lucianpapadopol/ArduinoDUE-VNA/Pic's/test_dds_b.jpg

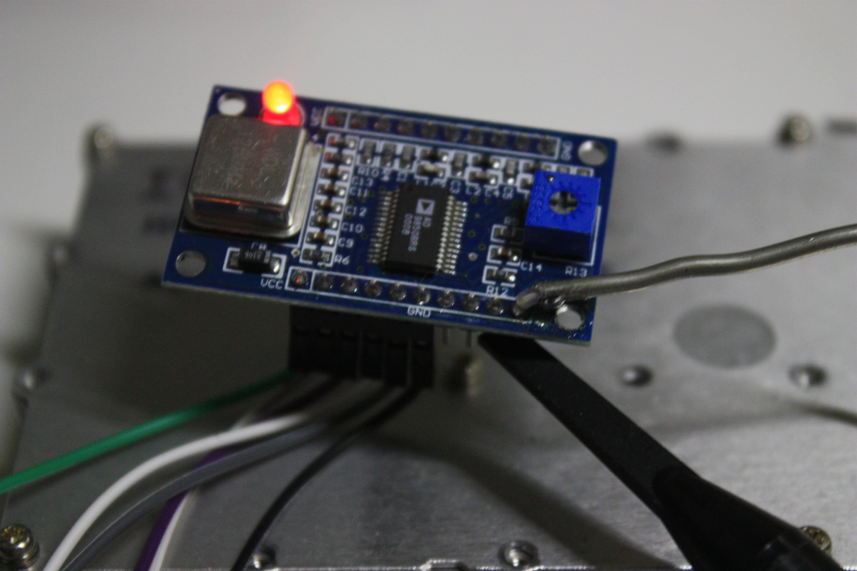
Pic's/test_dds_b.jpg
