lucianpapadopol/ArduinoDUE-VNA/Pic's/test_dds_uscita_b.jpg

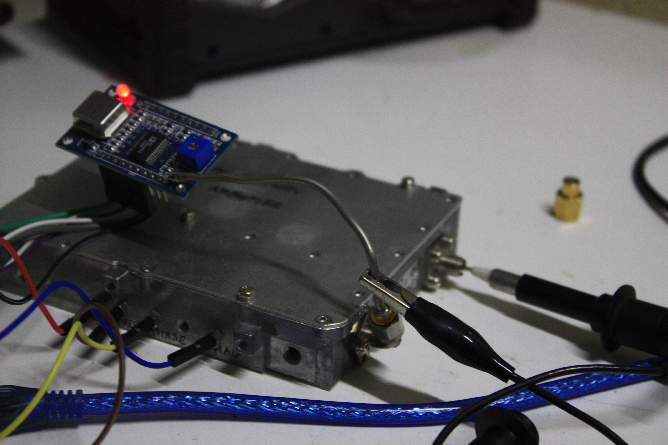
Pic's/test_dds_uscita_b.jpg
