lucianpapadopol/ArduinoDUE-VNA/DOC & INFO/schema a blocchi.jpg

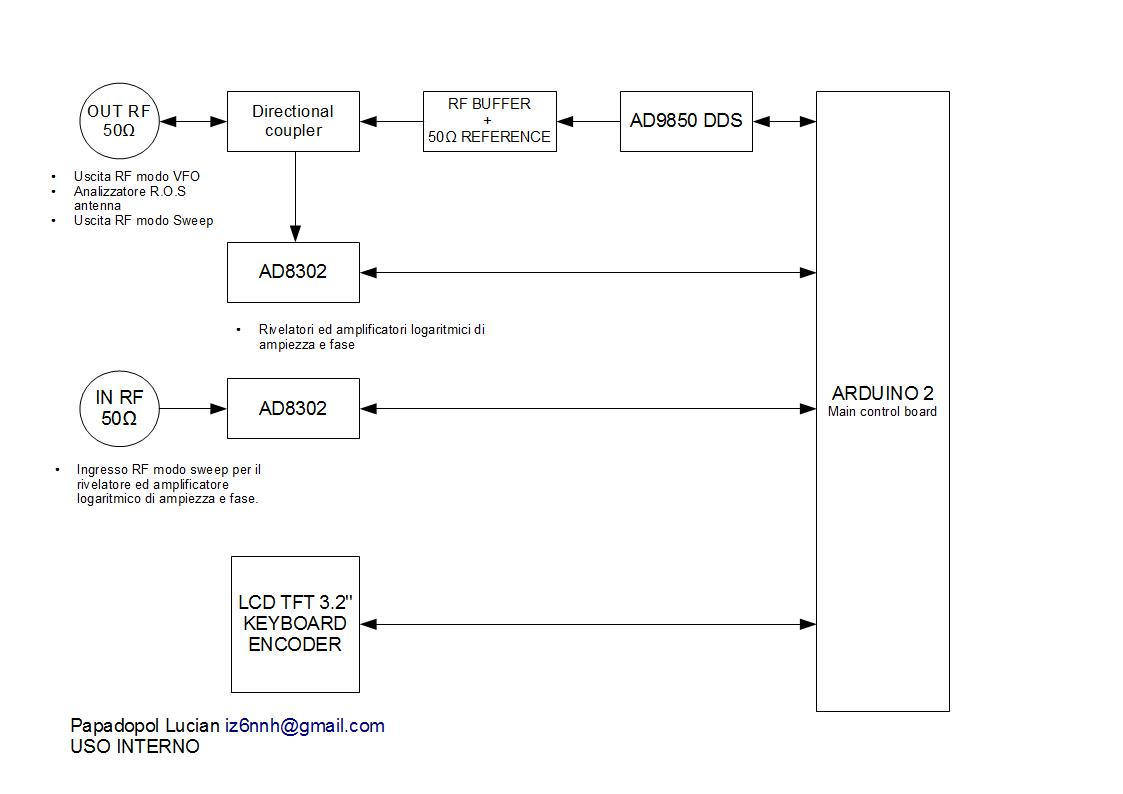
DOC & INFO/schema a blocchi.jpg
