lucianpapadopol/ArduinoDUE-VNA/Pic's/accoppiatore_pcb_a.jpg

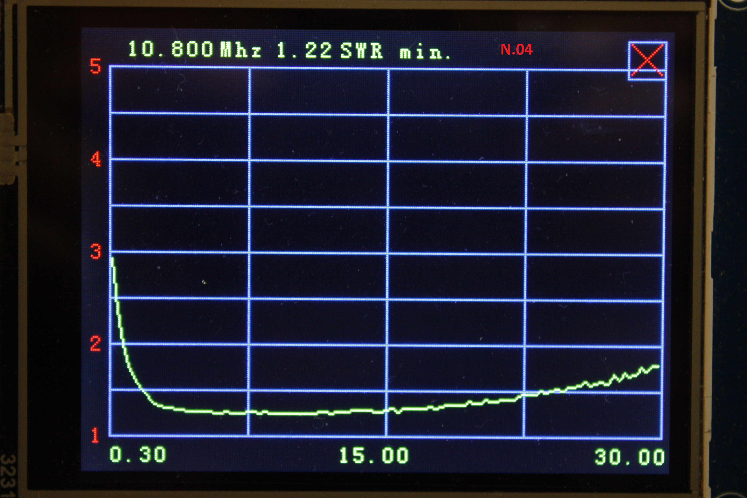
Pic's/accoppiatore_pcb_a.jpg
