lucianpapadopol/ArduinoDUE-VNA/Pic's/accoppiatore_pcb_b.jpg

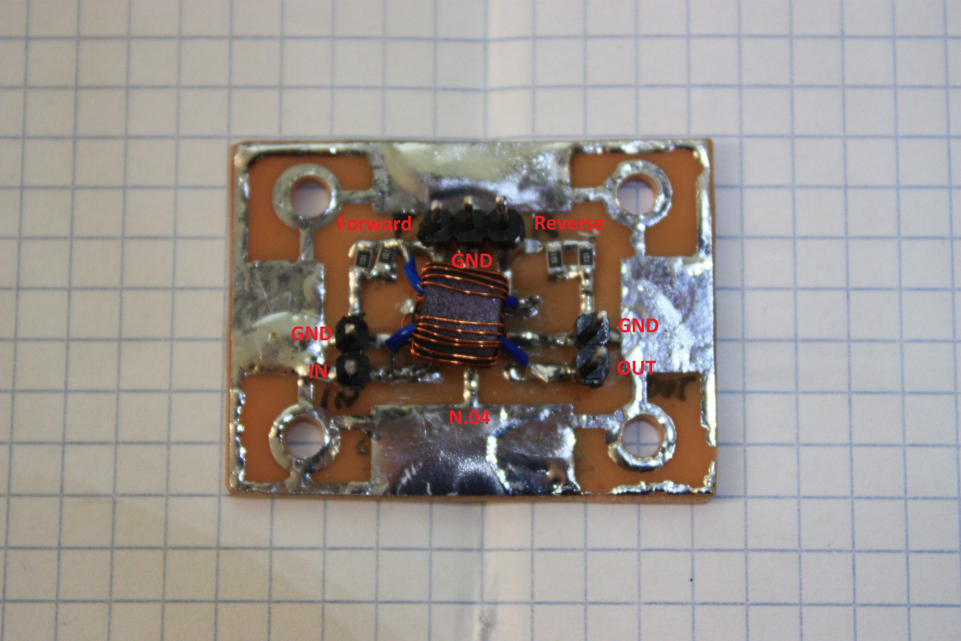
Pic's/accoppiatore_pcb_b.jpg
