lucianpapadopol/ArduinoDUE-VNA/Pic's/ad8302.jpg

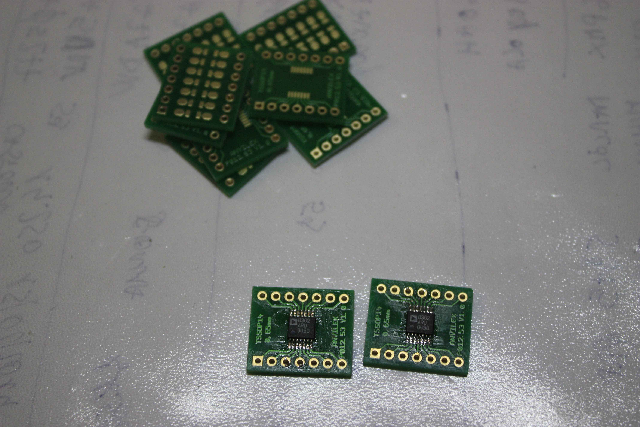
Pic's/ad8302.jpg
