lucianpapadopol/ArduinoDUE-VNA/Pic's/ad8302_b.jpg

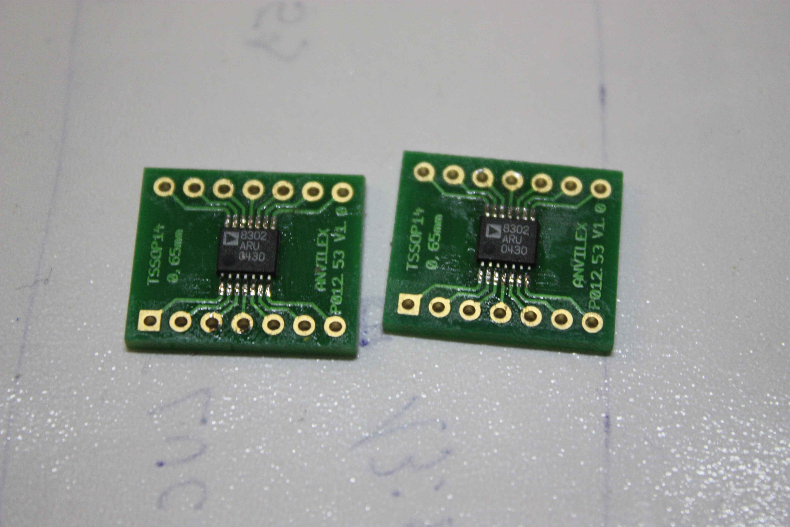
Pic's/ad8302_b.jpg
