lucianpapadopol/ArduinoDUE-VNA/Pic's/dds_conn.jpg

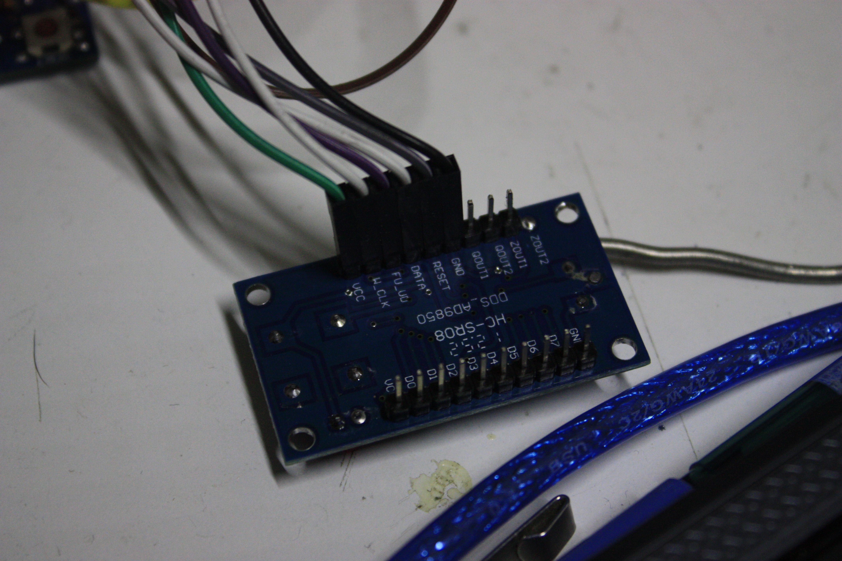
Pic's/dds_conn.jpg
