lucianpapadopol/ArduinoDUE-VNA/Pic's/fase.png

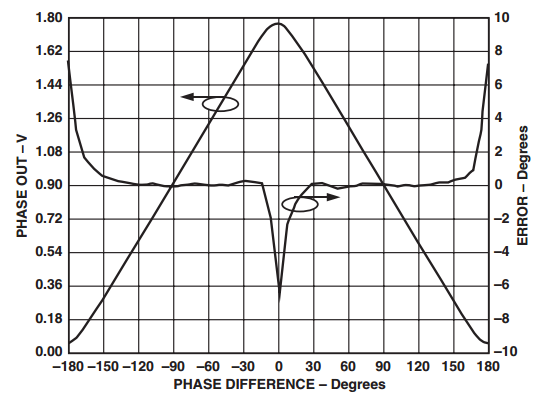
Pic's/fase.png
