lucianpapadopol/ArduinoDUE-VNA/Pic's/grafico swr.jpg

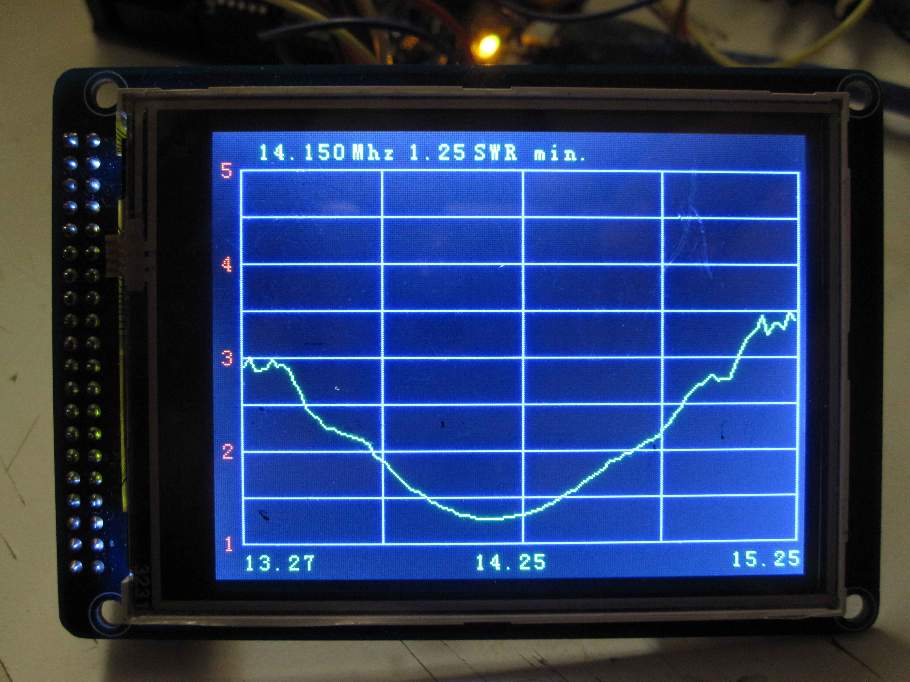
Pic's/grafico swr.jpg
