lucianpapadopol/ArduinoDUE-VNA/Pic's/logamp2.jpg

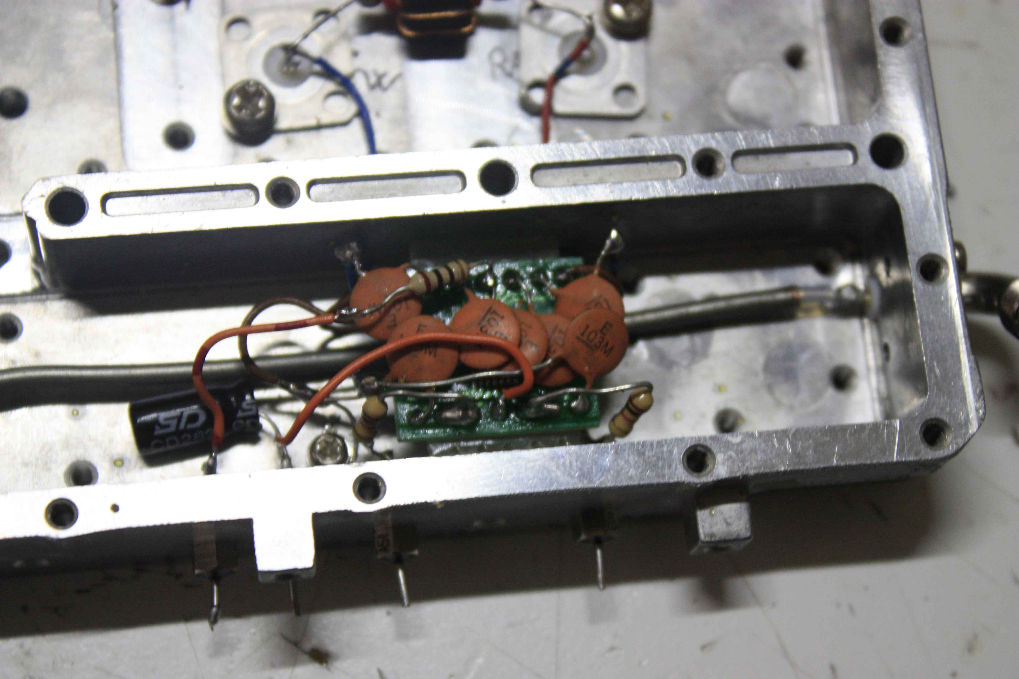
Pic's/logamp2.jpg
