lucianpapadopol/ArduinoDUE-VNA/Pic's/logamp3.jpg

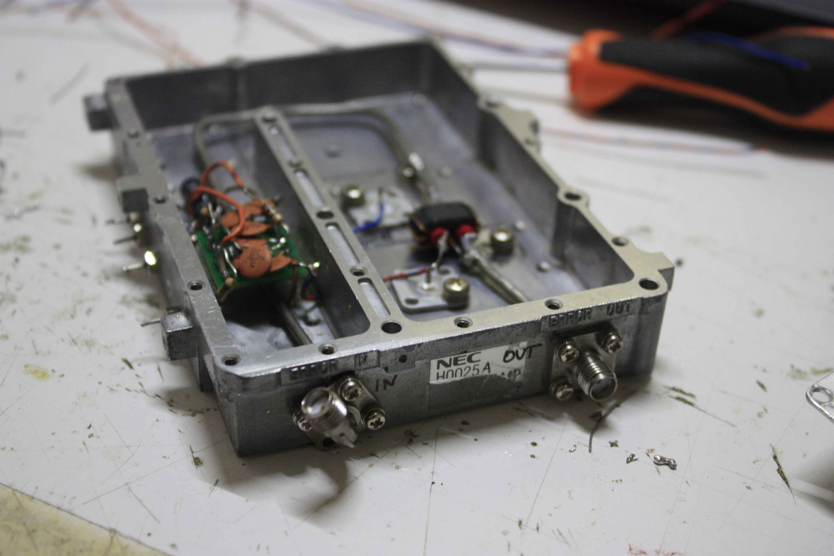
Pic's/logamp3.jpg
