lucianpapadopol/ArduinoDUE-VNA/Pic's/logamp4.jpg

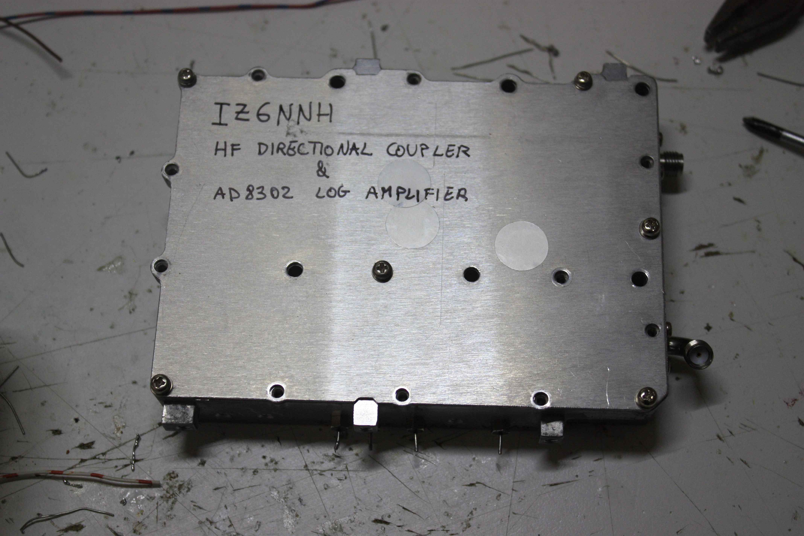
Pic's/logamp4.jpg
