lucianpapadopol/ArduinoDUE-VNA/Pic's/logamp.jpg

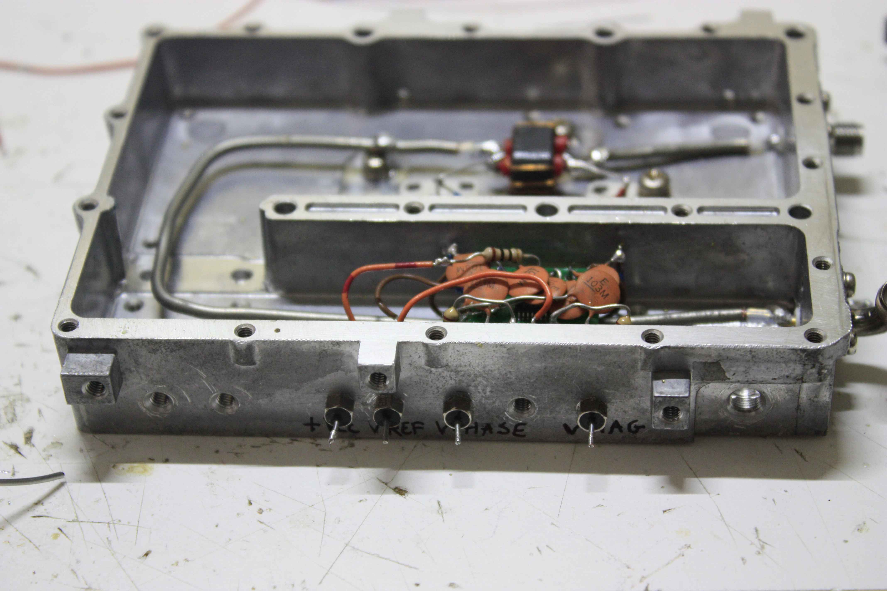
Pic's/logamp.jpg
