lucianpapadopol/ArduinoDUE-VNA/Pic's/mod_rf.jpg

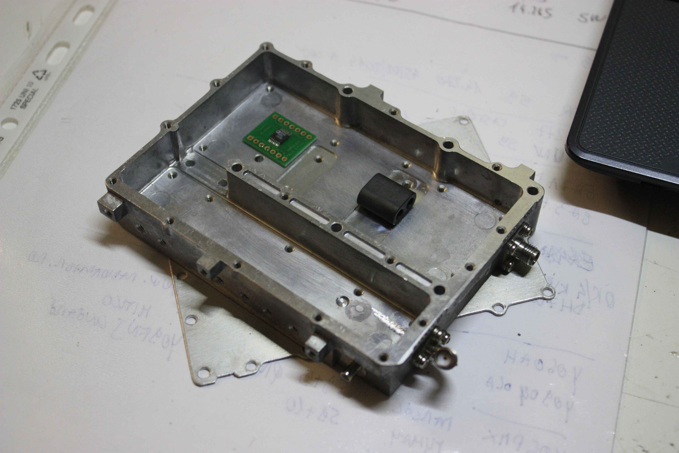
Pic's/mod_rf.jpg
