lucianpapadopol/ArduinoDUE-VNA/Pic's/modalità_vfo.jpg

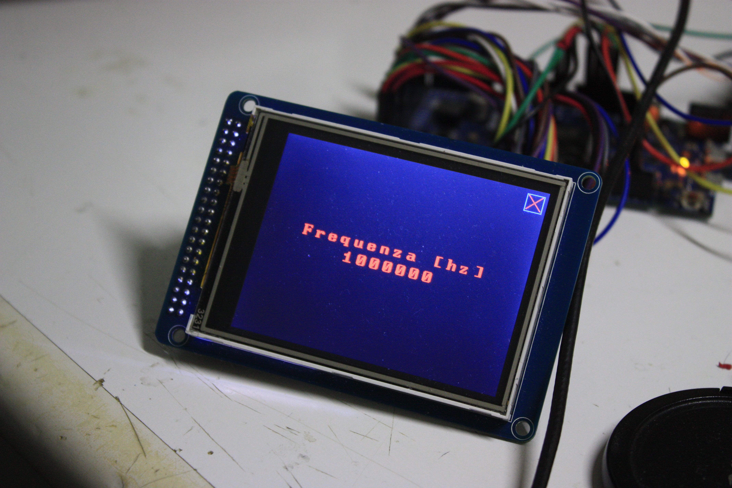
Pic's/modalità_vfo.jpg
