lucianpapadopol/ArduinoDUE-VNA/Pic's/tandem_match_coupler1.jpg

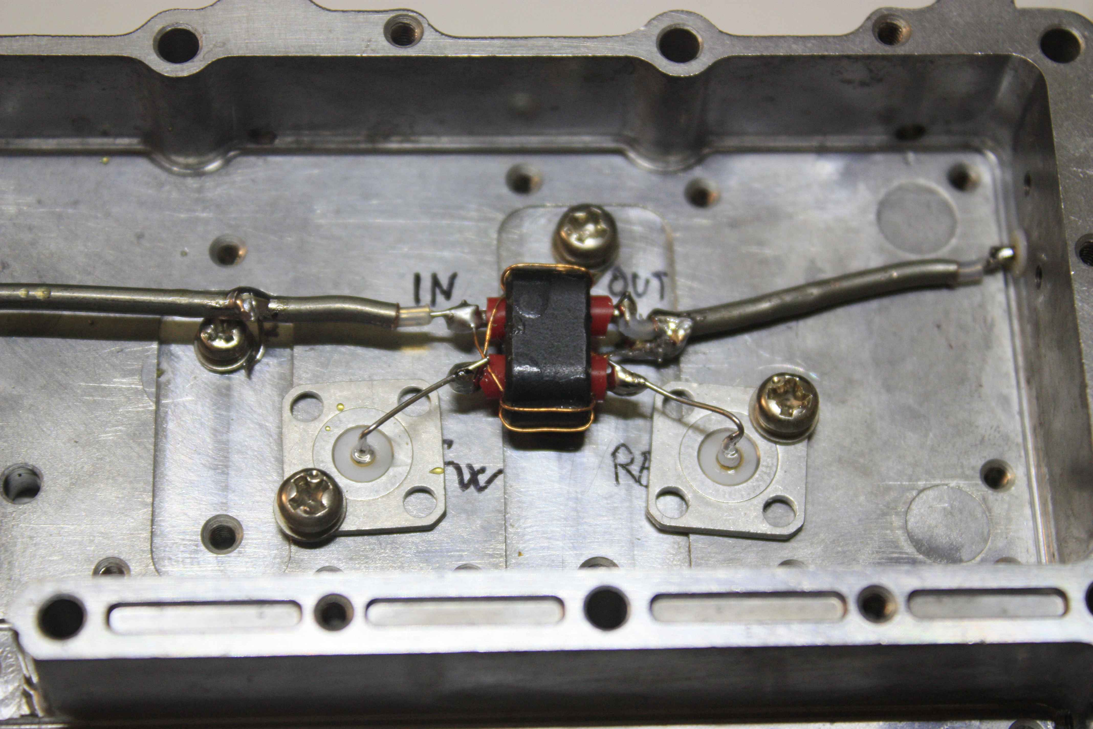
Pic's/tandem_match_coupler1.jpg
