lucianpapadopol/ArduinoDUE-VNA/Pic's/tandem_match_coupler2.jpg

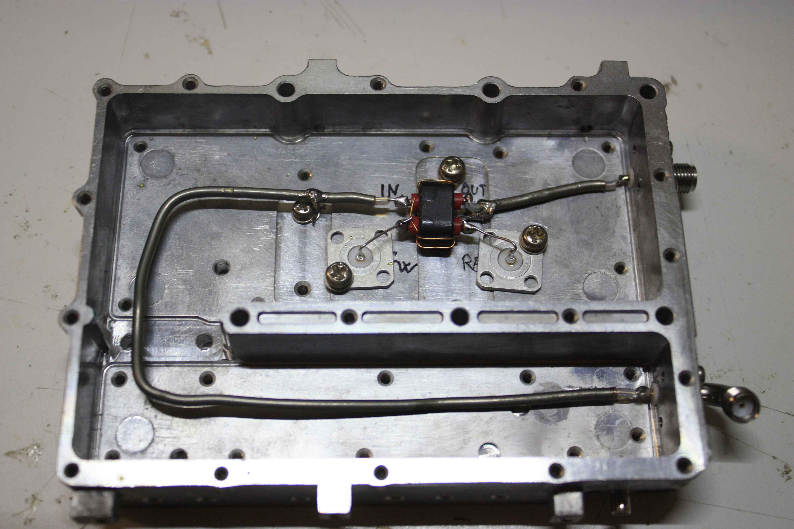
Pic's/tandem_match_coupler2.jpg
