lucianpapadopol/ArduinoDUE-VNA/Pic's/uscita_1mhz_dds.jpg

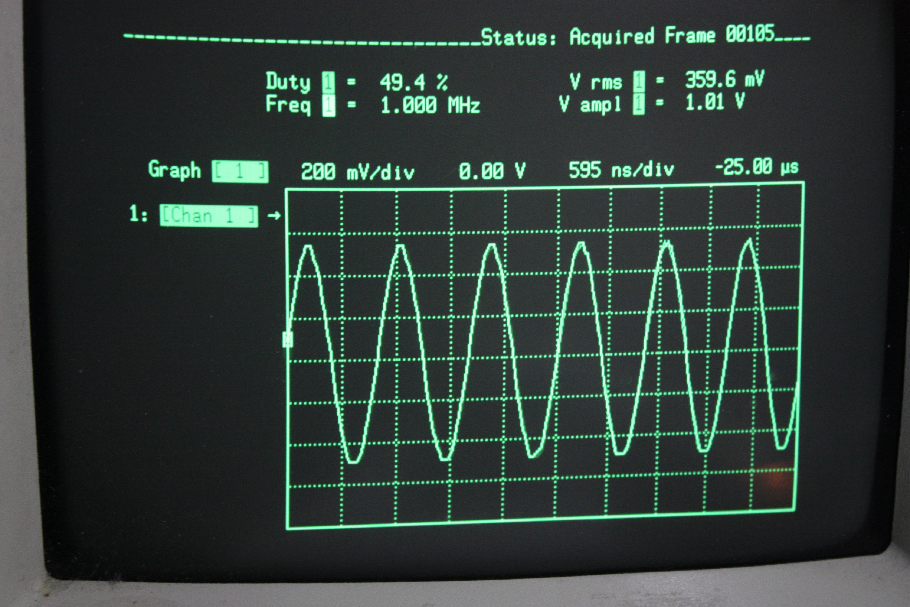
Pic's/uscita_1mhz_dds.jpg
