lucianpapadopol/ArduinoDUE-VNA/Pic's/vista d'insieme.jpg

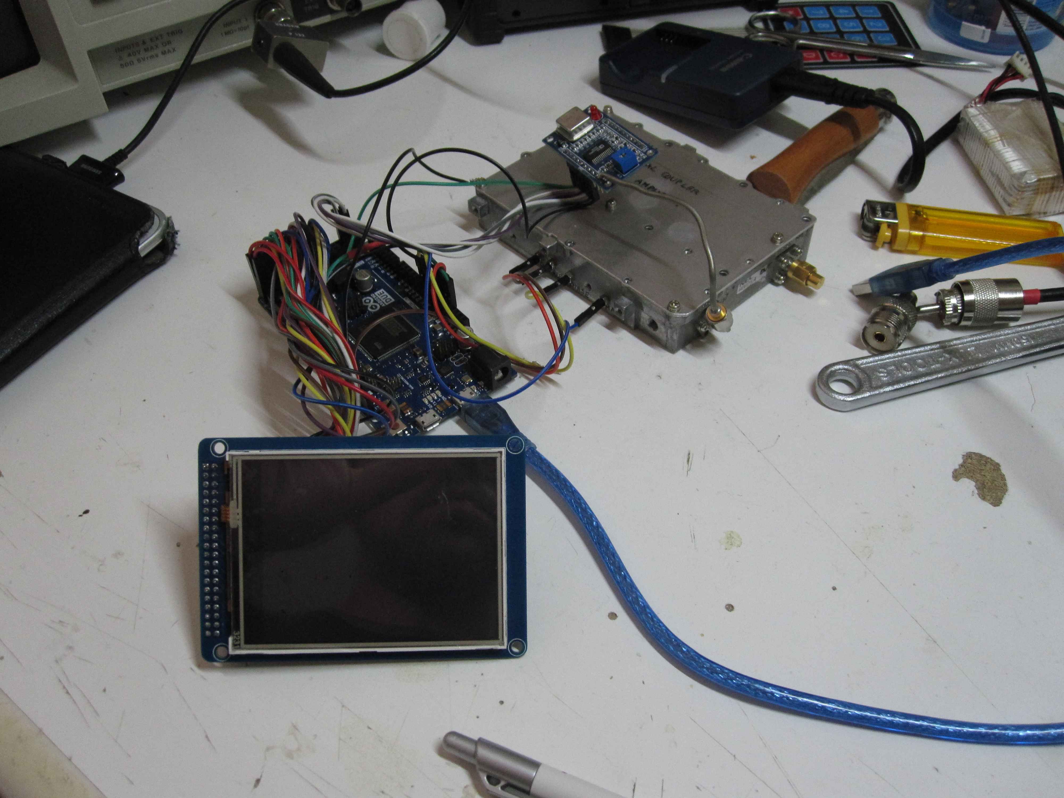
Pic's/vista d'insieme.jpg
