lucianpapadopol/ArduinoDUE-VNA/Pic's/vista_di_insieme.jpg

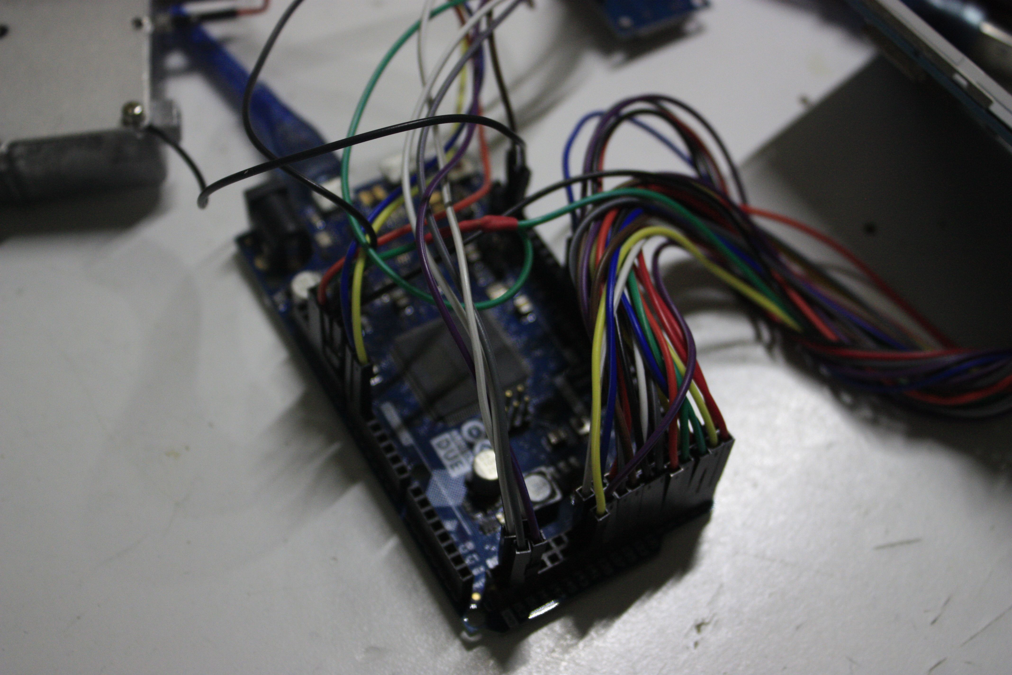
Pic's/vista_di_insieme.jpg
