lucianpapadopol/ArduinoDUE-VNA/(list of files, cad)

Other CAD files:
Library DOC's/5inchmodule/51 keil sample code/8KROM MCU/main.OBJ
Library DOC's/5inchmodule/51 keil sample code/16kROM MCU/综合测试(要求大于16K ROM的单片机)/main.OBJ
Library DOC's/5inchmodule/51 keil sample code/16kROM MCU/综合测试(要求大于16K ROM的单片机)/font.obj
Library DOC's/5inchmodule/51 keil sample code/8KROM MCU/sys.obj
Library DOC's/5inchmodule/51 keil sample code/16kROM MCU/综合测试(要求大于16K ROM的单片机)/sys.obj
Library DOC's/5inchmodule/51 keil sample code/8KROM MCU/touch.obj
Library DOC's/5inchmodule/51 keil sample code/16kROM MCU/综合测试(要求大于16K ROM的单片机)/STARTUP.OBJ
Library DOC's/5inchmodule/51 keil sample code/8KROM MCU/STARTUP.OBJ
Library DOC's/5inchmodule/51 keil sample code/16kROM MCU/综合测试(要求大于16K ROM的单片机)/LCD.obj
Library DOC's/5inchmodule/51 keil sample code/8KROM MCU/font.obj
Library DOC's/5inchmodule/51 keil sample code/16kROM MCU/综合测试(要求大于16K ROM的单片机)/touch.obj
Library DOC's/5inchmodule/51 keil sample code/8KROM MCU/LCD.obj
