lucianpapadopol/ArduinoDUE-VNA/Pic's/dir_coupler_test_a2.jpg

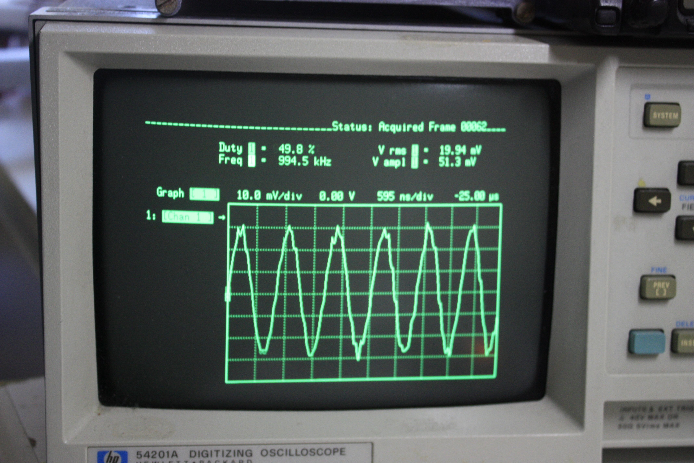
Pic's/dir_coupler_test_a2.jpg
