lucianpapadopol/ArduinoDUE-VNA/Pic's/dir_coupler_test_a3.jpg

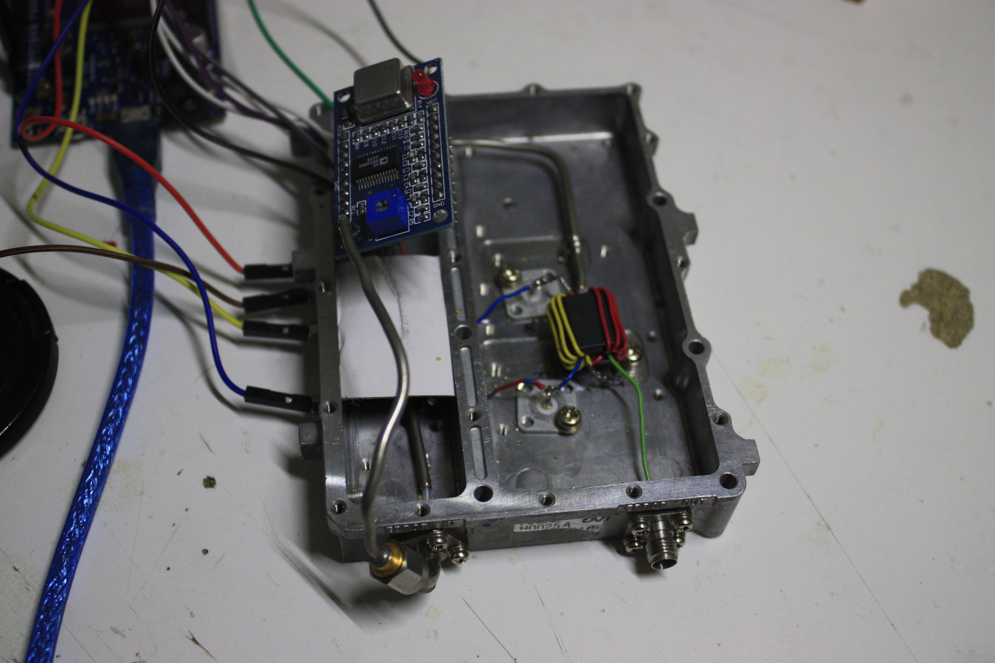
Pic's/dir_coupler_test_a3.jpg
