lucianpapadopol/ArduinoDUE-VNA/Pic's/dir_coupler_test_a.jpg

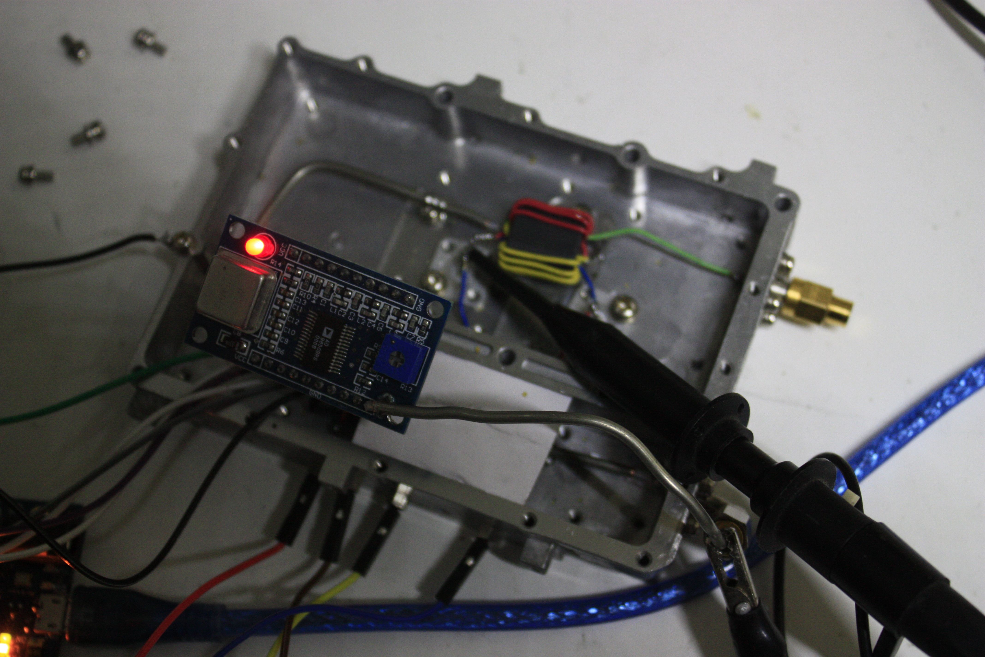
Pic's/dir_coupler_test_a.jpg
