lucianpapadopol/ArduinoDUE-VNA/Pic's/test_dds.jpg

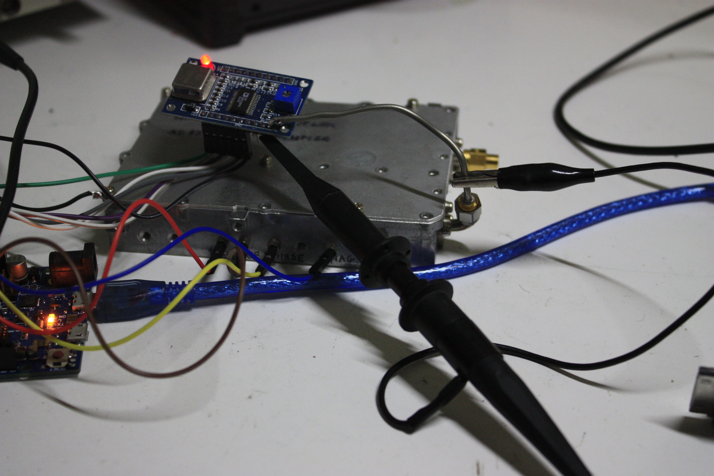
Pic's/test_dds.jpg
