lucianpapadopol/ArduinoDUE-VNA/Pic's/test_dds_uscita.jpg

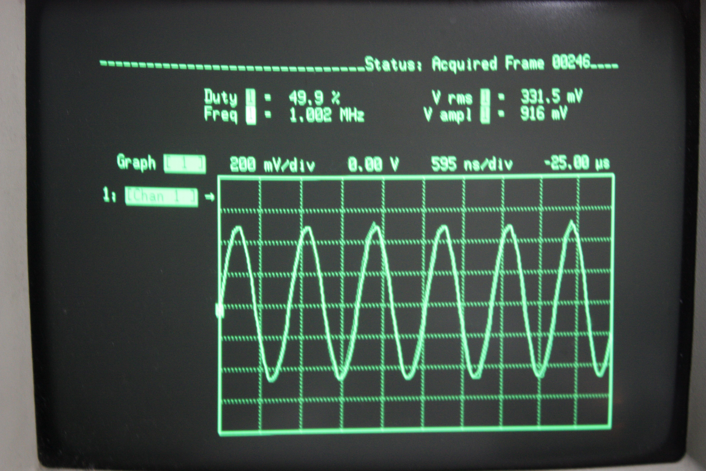
Pic's/test_dds_uscita.jpg
